psurply/lse-pc/hw/cad/acrylic_case_top.fcstd

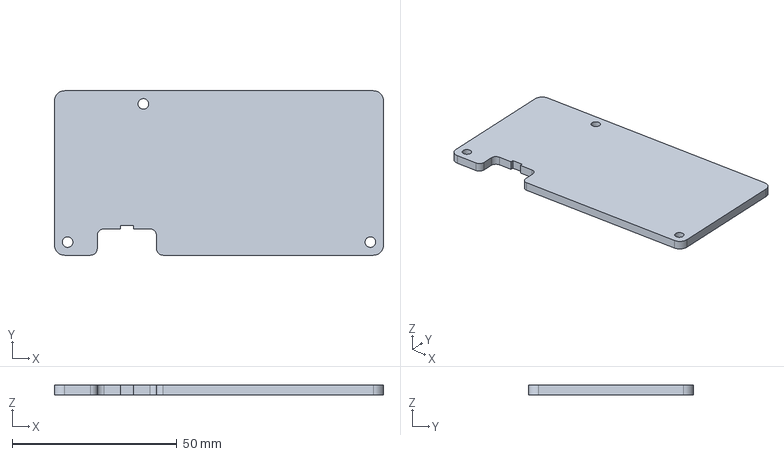
[picture p1: CAD file, 2016-10-15]
hw/cad/acrylic_case_top.fcstd
100.0 x 50.0 x 3.00 mm
