psurply/lse-pc/(list of files, cad)

Other CAD files:
sw/bridge/stp/cpu_signals.stp
