psurply/lse-pc/(list of files, drawings)

Other design files:
hw/pcb/logo/logo.pcb
hw/pcb/mobo.pcb
