psurply/lse-pc/sw/bridge/rtl/supervisor/software/supervisor/ocd_prgm.h

#ifndef OCD_PRGM_H
#define OCD_PRGM_H

#include <stdint.h>

static const uint8_t ocd_prgm_reset[] = {
	0x00, 0x41,	/* 0 */
	0x00, 0x02,	/* 1 */
	0x00, 0x00,	/* 2 */
};

static const uint8_t ocd_prgm_write_io[] = {
	0x30, 0x34,	/* 0 */
	0x00, 0x03,	/* 1 */
	0x00, 0x49,	/* 2 */
	0x01, 0x22,	/* 3 */
	0x02, 0x25,	/* 4 */
	0x00, 0x00,	/* 5 */
};

static const uint8_t ocd_prgm_read_io[] = {
	0x03, 0x24,	/* 0 */
	0x00, 0x00,	/* 1 */
};

static const uint8_t ocd_prgm_cont[] = {
	0x01, 0x20,	/* 0 */
	0xcf, 0x90,	/* 1 */
	0x07, 0x20,	/* 2 */
	0x90, 0x90,	/* 3 */
	0x00, 0x42,	/* 4 */
	0x10, 0x34,	/* 5 */
	0x00, 0x42,	/* 6 */
	0x70, 0x34,	/* 7 */
	0x00, 0x42,	/* 8 */
	0x70, 0x34,	/* 9 */
	0x00, 0x42,	/* a */
	0x70, 0x34,	/* b */
	0x00, 0x42,	/* c */
	0x50, 0x34,	/* d */
	0x00, 0x42,	/* e */
	0x60, 0x34,	/* f */
	0x00, 0x42,	/* 10 */
	0x40, 0x34,	/* 11 */
	0x00, 0x42,	/* 12 */
	0x00, 0x34,	/* 13 */
	0x00, 0x42,	/* 14 */
	0x20, 0x34,	/* 15 */
	0x00, 0x42,	/* 16 */
	0x30, 0x34,	/* 17 */
	0x00, 0x03,	/* 18 */
	0x00, 0x49,	/* 19 */
	0x01, 0x22,	/* 1a */
	0x02, 0x25,	/* 1b */
	0x00, 0x00,	/* 1c */
};

static const uint8_t ocd_prgm_break[] = {
	0x00, 0x45,	/* 0 */
	0x00, 0x48,	/* 1 */
	0x02, 0x22,	/* 2 */
	0x03, 0x23,	/* 3 */
	0x20, 0x28,	/* 4 */
	0x01, 0x20,	/* 5 */
	0x08, 0x00,	/* 6 */
	0x10, 0x60,	/* 7 */
	0x0b, 0x71,	/* 8 */
	0x30, 0x28,	/* 9 */
	0x43, 0x71,	/* a */
	0x01, 0x20,	/* b */
	0x00, 0x8e,	/* c */
	0x10, 0x34,	/* d */
	0x00, 0x42,	/* e */
	0x01, 0x20,	/* f */
	0x0d, 0x00,	/* 10 */
	0x10, 0x34,	/* 11 */
	0x00, 0x42,	/* 12 */
	0x01, 0x20,	/* 13 */
	0x00, 0x00,	/* 14 */
	0x10, 0x34,	/* 15 */
	0x00, 0x42,	/* 16 */
	0x01, 0x20,	/* 17 */
	0x08, 0x00,	/* 18 */
	0x10, 0x34,	/* 19 */
	0x00, 0x42,	/* 1a */
	0x01, 0x20,	/* 1b */
	0x00, 0x9a,	/* 1c */
	0x10, 0x34,	/* 1d */
	0x00, 0x42,	/* 1e */
	0x01, 0x20,	/* 1f */
	0xcf, 0x00,	/* 20 */
	0x10, 0x34,	/* 21 */
	0x00, 0x42,	/* 22 */
	0x01, 0x20,	/* 23 */
	0xff, 0xff,	/* 24 */
	0x10, 0x34,	/* 25 */
	0x00, 0x42,	/* 26 */
	0x01, 0x20,	/* 27 */
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
};

static const uint8_t ocd_prgm_get_regs[] = {
	0x01, 0x20,	/* 0 */
	0x60, 0x90,	/* 1 */
	0x02, 0x20,	/* 2 */
	0x90, 0x90,	/* 3 */
	0x00, 0x42,	/* 4 */
	0x10, 0x34,	/* 5 */
	0x00, 0x42,	/* 6 */
	0x20, 0x34,	/* 7 */
	0x00, 0x42,	/* 8 */
	0x20, 0x34,	/* 9 */
	0x00, 0x42,	/* a */
	0x20, 0x34,	/* b */
	0x00, 0x42,	/* c */
	0x20, 0x34,	/* d */
	0x00, 0x42,	/* e */
	0x00, 0x24,	/* f */
	0x00, 0x43,	/* 10 */
	0x00, 0x42,	/* 11 */
	0x01, 0x24,	/* 12 */
	0x00, 0x43,	/* 13 */
	0x00, 0x42,	/* 14 */
	0x02, 0x24,	/* 15 */
	0x00, 0x43,	/* 16 */
	0x00, 0x42,	/* 17 */
	0x03, 0x24,	/* 18 */
	0x00, 0x43,	/* 19 */
	0x00, 0x42,	/* 1a */
	0x04, 0x24,	/* 1b */
	0x00, 0x43,	/* 1c */
	0x00, 0x42,	/* 1d */
	0x05, 0x24,	/* 1e */
	0x00, 0x43,	/* 1f */
	0x00, 0x42,	/* 20 */
	0x06, 0x24,	/* 21 */
	0x00, 0x43,	/* 22 */
	0x00, 0x42,	/* 23 */
	0x07, 0x24,	/* 24 */
	0x00, 0x43,	/* 25 */
	0x00, 0x42,	/* 26 */
	0x08, 0x24,	/* 27 */
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
};

static const uint8_t ocd_prgm_set_reg[] = {
	0x04, 0x20,	/* 0 */
	0x90, 0x90,	/* 1 */
	0x00, 0x42,	/* 2 */
	0x10, 0x34,	/* 3 */
	0x00, 0x42,	/* 4 */
	0x20, 0x34,	/* 5 */
	0x00, 0x42,	/* 6 */
	0x30, 0x34,	/* 7 */
	0x00, 0x42,	/* 8 */
	0x40, 0x34,	/* 9 */
	0x00, 0x42,	/* a */
	0x40, 0x34,	/* b */
	0x00, 0x46,	/* c */
	0x00, 0x00,	/* d */
};

static const uint8_t ocd_prgm_start[] = {
	0x00, 0x40,	/* 0 */
	0x00, 0x03,	/* 1 */
	0x00, 0x49,	/* 2 */
	0x01, 0x22,	/* 3 */
	0x02, 0x25,	/* 4 */
	0x00, 0x00,	/* 5 */
};

#endif /* OCD_PRGM_H */
