psurply/lse-pc/sw/bios/include/types.h

#ifndef TYPES_H_
# define TYPES_H_

typedef unsigned long	size_t;

typedef unsigned int	uword;
typedef int		sword;

typedef unsigned char		u8;
typedef signed char		s8;
typedef unsigned short		u16;
typedef signed short		s16;
typedef unsigned long		u32;
typedef signed long		s32;
typedef unsigned long long	u64;
typedef signed long long	s64;

#endif /* !TYPES_H_ */
